fotcraft/piwithjimmy/design_enclosure/renders/back.png

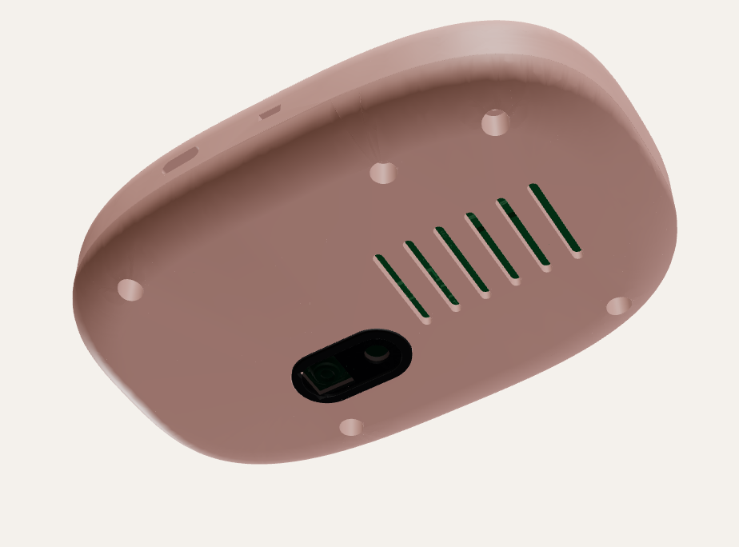
design_enclosure/renders/back.png
