fotcraft/piwithjimmy/design_enclosure/renders/buttons.png

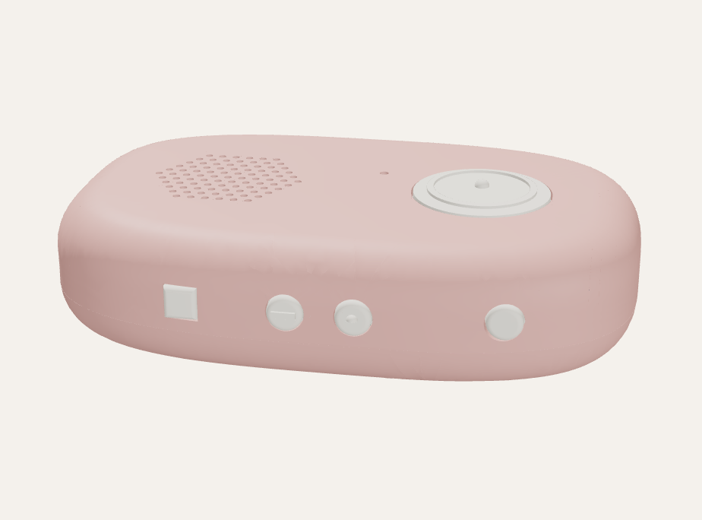
design_enclosure/renders/buttons.png
