fotcraft/piwithjimmy/design_enclosure/renders/camera.png

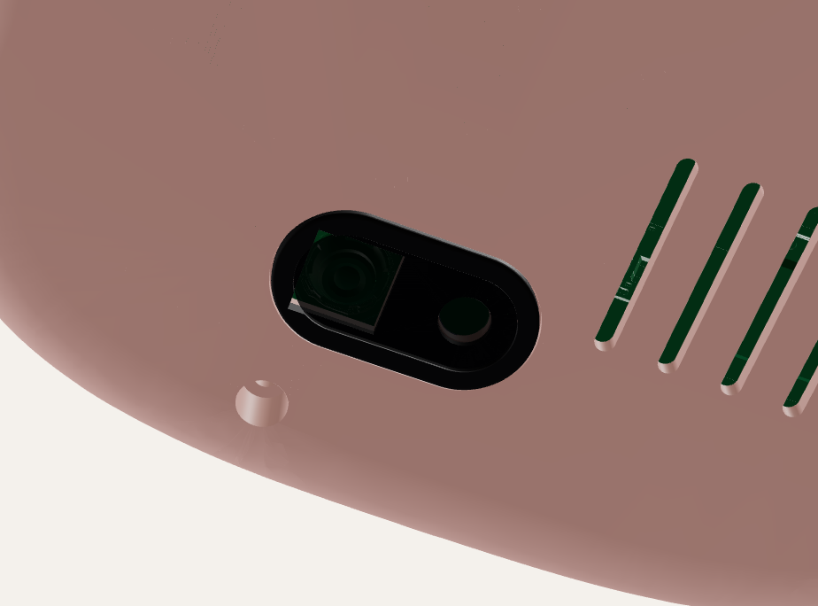
design_enclosure/renders/camera.png
