fotcraft/piwithjimmy/design_enclosure/renders/exploded.png

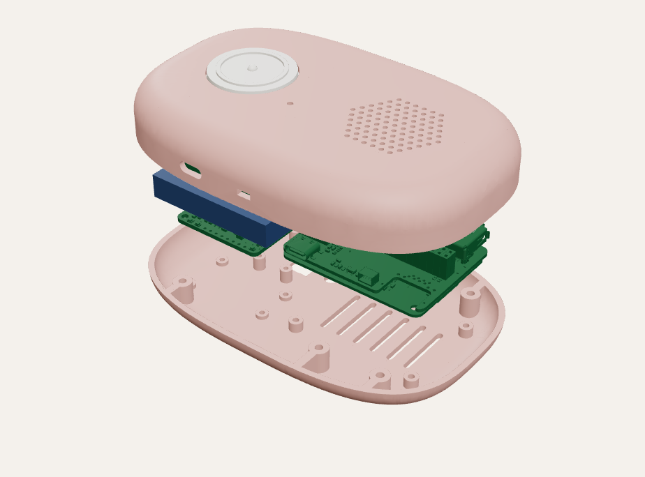
design_enclosure/renders/exploded.png
