fotcraft/piwithjimmy/design_enclosure/renders/section.png

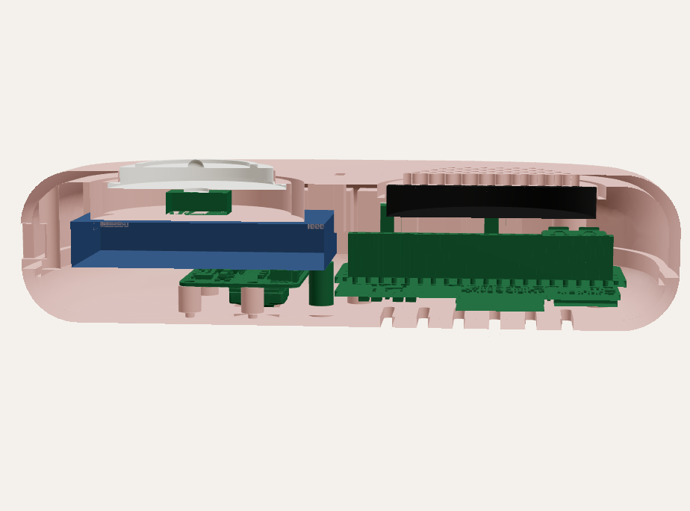
design_enclosure/renders/section.png
