fotcraft/piwithjimmy/design_enclosure/out/readable_assembly.step

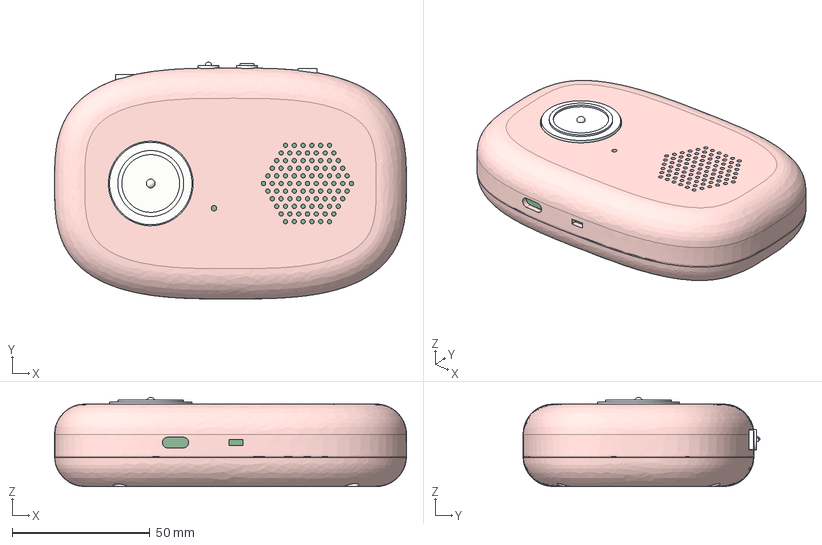
[picture p7: CAD file, 2026-11-05]
design_enclosure/out/readable_assembly.step
128.0 x 86.2 x 32.4 mm
front
back
cap_scan
cap_repeat
cap_vol_up
cap_vol_down
cap_lang
battery
speaker
amp
scan_switch
sw_repeat
sw_vol_up
sw_vol_down
sw_lang
usbc_breakout
power_switch
status_led
illum_led
