fotcraft/piwithjimmy/design_enclosure/out/cap_lang.step

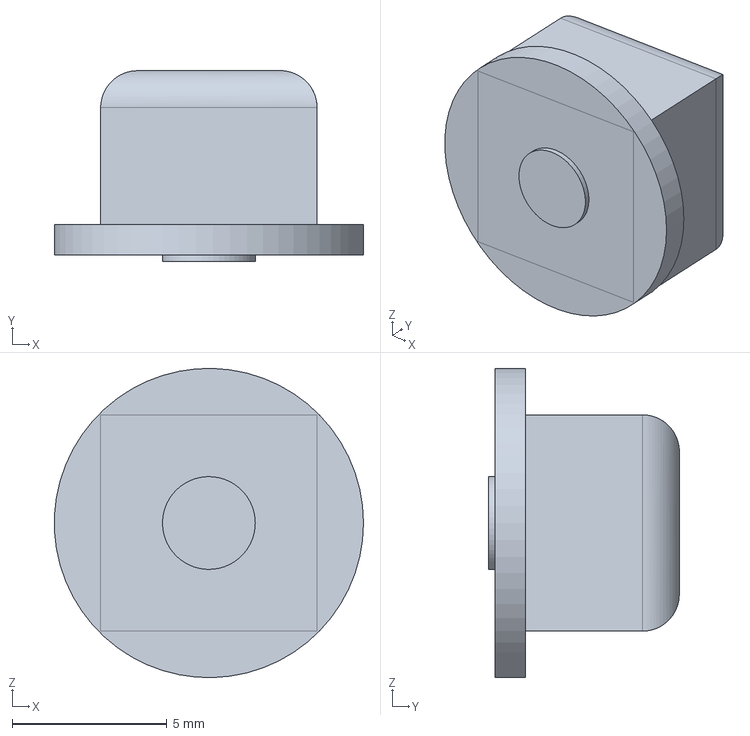
[picture p8: CAD file, 2026-11-06]
design_enclosure/out/cap_lang.step
9.99 x 6.17 x 10.00 mm
