fotcraft/piwithjimmy/design_enclosure/PowerBoost_1000C.step

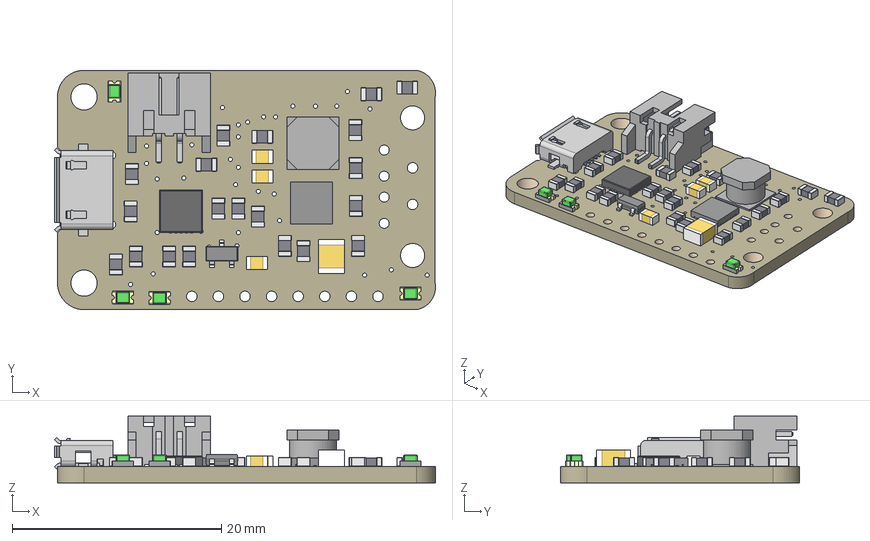
[picture p9: CAD file, 2026-02-16]
design_enclosure/PowerBoost_1000C.step
36.4 x 22.9 x 6.37 mm
Board
TPS61090RSAR
6.8uH
15K x 20
JST 2-PH
ORANGE x 4
0.1uF
1.87M x 2
MMUN2133LT1G
100uF
MicroUSB
MCP73871
