fotcraft/piwithjimmy/design_enclosure/CM5R5-3dsteps.step

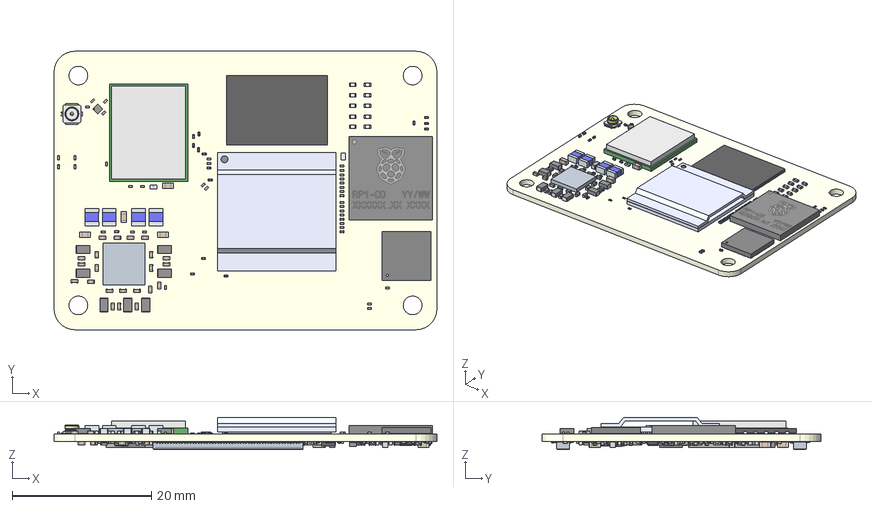
[picture p10: CAD file, 2026-02-15]
design_enclosure/CM5R5-3dsteps.step
55.0 x 40.0 x 4.62 mm
200-ball_VFBGAold.step
CAP0201.step x 190
RES0201old.step x 71
CAP0402.step x 81
PMIC STEP.STEP
3D-SRP201208-R47MH-20230512 .step x 7
term2 x 4
term1 x 4
2712 v2 STEP.STEP
CAP0603.step x 10
RES0402.step x 10
SOT883B Mold body x 4
SOT883B4 LF x 4
User Library-SKY13351-378LF.step
ProjectY v3 STEP.STEP
(Unsaved)
PinIndicator
Pads x 2
Lid x 2
Plating
LDF
CPD
Pins
User Library-153BallWFBGA
10164228-1001A1RLF.stp x 2
ABM11-0022-T3.step x 2
DIELECTRIC_Model_1_Inst
