fotcraft/piwithjimmy/design_enclosure/out/cap_scan.step

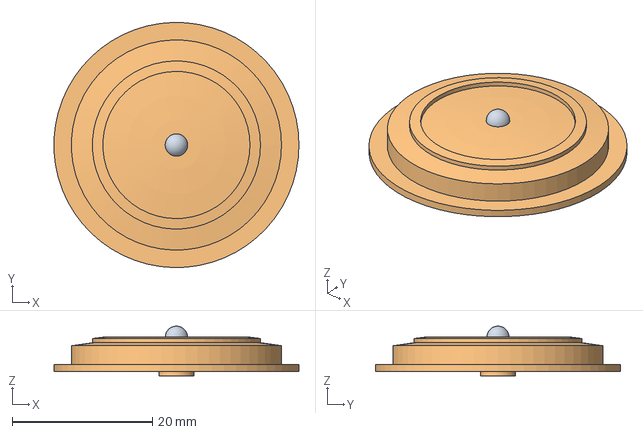
[picture p11: CAD file, 2026-11-06]
design_enclosure/out/cap_scan.step
35.0 x 35.0 x 7.10 mm
