fotcraft/piwithjimmy/design_enclosure/out/cap_vol_down.step

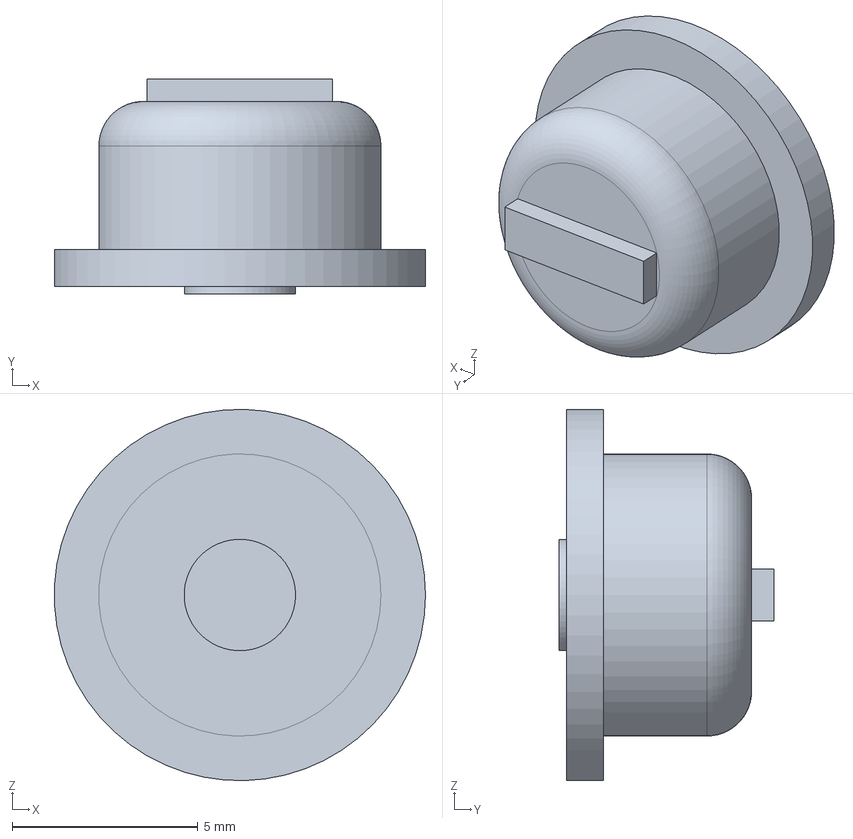
[picture p12: CAD file, 2026-11-06]
design_enclosure/out/cap_vol_down.step
9.99 x 5.79 x 10.00 mm
