fotcraft/piwithjimmy/design_enclosure/out/camera_window.step

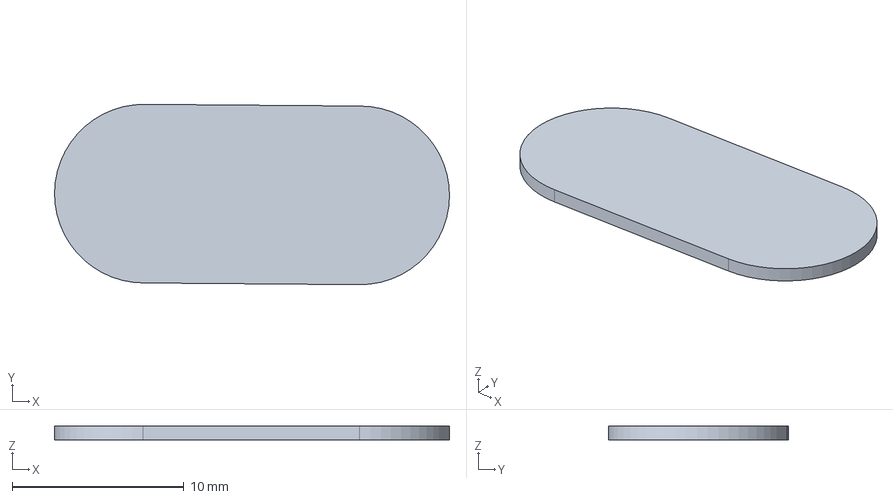
[picture p13: CAD file, 2026-11-06]
design_enclosure/out/camera_window.step
23.0 x 10.5 x 0.8 mm
