fotcraft/piwithjimmy/design_enclosure/out/cap_repeat.step

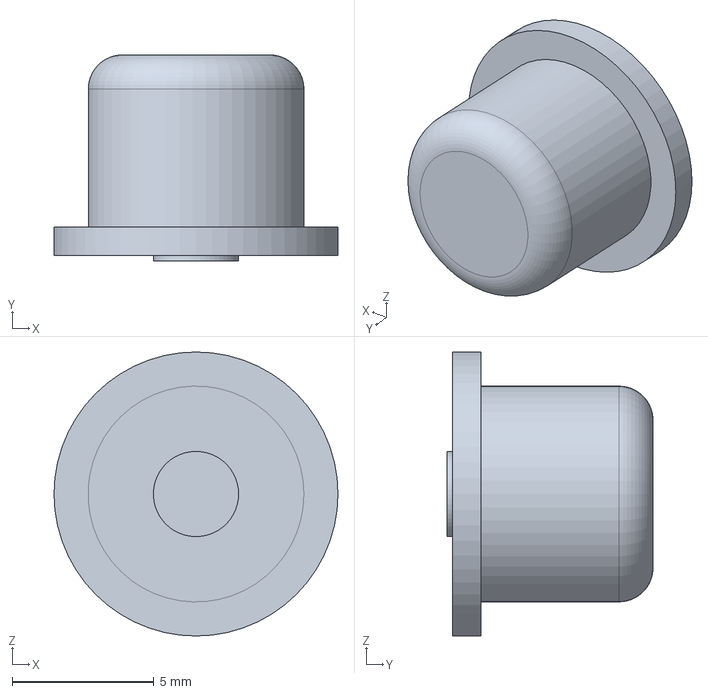
[picture p14: CAD file, 2026-11-06]
design_enclosure/out/cap_repeat.step
10.0 x 7.26 x 10.0 mm
