fotcraft/piwithjimmy/design_enclosure/out/camera_bezel.step

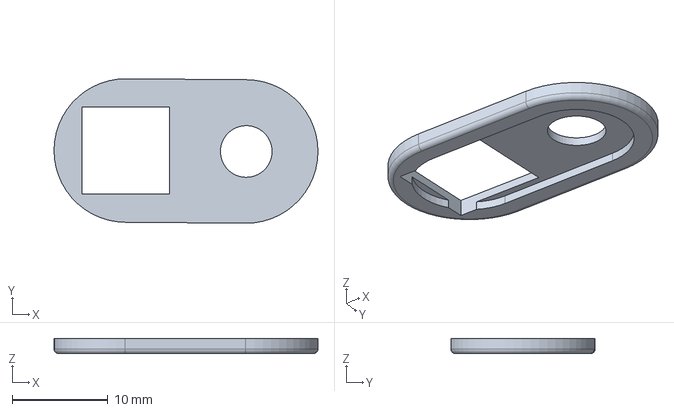
[picture p15: CAD file, 2026-11-06]
design_enclosure/out/camera_bezel.step
27.6 x 15.1 x 1.60 mm
