fotcraft/piwithjimmy/design_enclosure/out/back.step

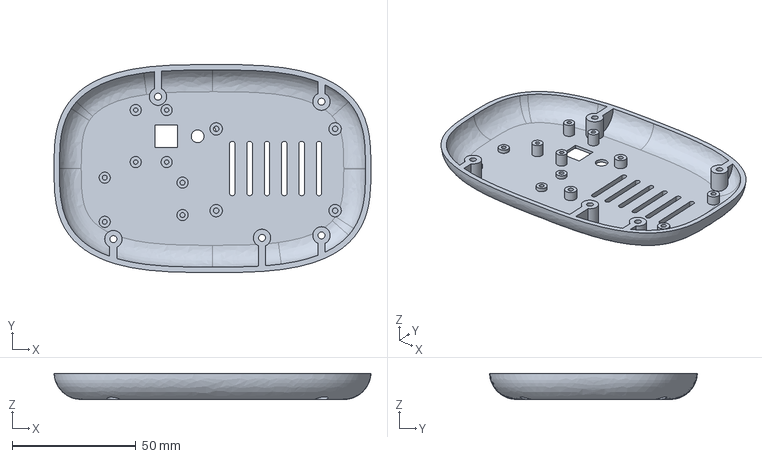
[picture p16: CAD file, 2026-11-06]
design_enclosure/out/back.step
128.0 x 84.0 x 10.5 mm
