fotcraft/piwithjimmy/design_enclosure/out/front.step

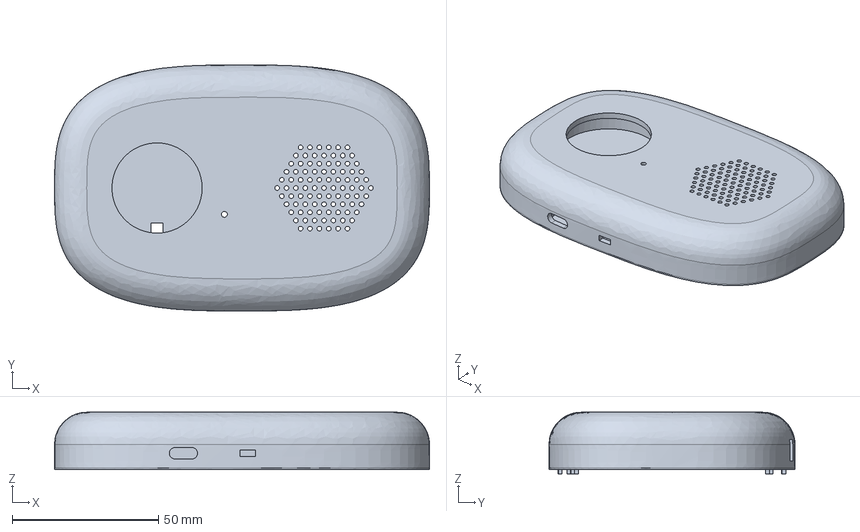
[picture p17: CAD file, 2026-11-05]
design_enclosure/out/front.step
128.0 x 84.0 x 21.0 mm
