fotcraft/piwithjimmy/design_enclosure/out/cap_vol_up.step

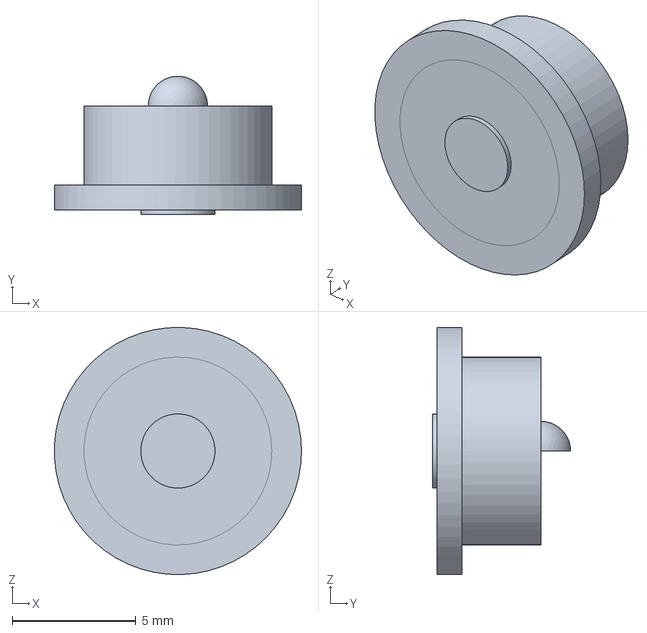
[picture p18: CAD file, 2026-11-05]
design_enclosure/out/cap_vol_up.step
9.99 x 5.60 x 10.00 mm
