fotcraft/piwithjimmy/(list of files, cad)

Other CAD files:
design_enclosure/out/back.stl
design_enclosure/out/cap_lang.stl
design_enclosure/out/cap_repeat.stl
design_enclosure/out/cap_scan.stl
design_enclosure/out/cap_vol_down.stl
design_enclosure/out/cap_vol_up.stl
design_enclosure/out/front.stl
