fotcraft/piwithjimmy/(commit log)

2026-02-15 Use Azure Read API as primary OCR for handwritten English notes
    Azure is now called first (cloud_ocr.primary: true) with local
    EasyOCR as fallback only when Azure fails. Preprocessing disabled
    to preserve handwriting, image auto-compressed to fit Azure's 4 MB
    limit, and error logging added throughout the cloud OCR path.
    [config.yaml]
2026-02-15 Add Azure Neural TTS, confidence fix, auto language detection, and enclosure STEP files
    - Azure Neural TTS (JennyNeural/AthinaNeural) with espeak-ng fallback
    - Use paplay for PipeWire/PulseAudio compatibility
    - Normalize Azure OCR confidence from 0-1 to 0-100 scale
    - Auto-detect language for OCR (supports English + Greek)
    - Add design_enclosure/ with official CM5 and Camera Module 3 STEP files
    [CM5R5-3dsteps.step]
2026-02-16 Update README with full project docs, add CM5-NANO-B and PowerBoost STEP files
    - Rewrite README with current architecture (Azure OCR + TTS),
    hardware BOM, config reference, and project structure
    - Add Waveshare CM5-NANO-B carrier board STEP file
    - Add Adafruit PowerBoost 1000C STEP file
    - Update remaining CAD download list
    [PowerBoost_1000C.step]
2026-11-05 Readable v2: Greek handwriting, offline Greek, real GPIO, audio fixes
    - Vision-language model OCR (Azure OpenAI / OpenAI / Anthropic) for
    handwriting, low confidence or empty Azure results; reads Greek handwriting,
    which Azure OCR does not support
    - Optional Azure Document Intelligence provider (lists Greek print)
    - Offline: Tesseract ell+eng by default, instant offline detection instead of
    waiting for cloud timeouts
    - gpiozero buttons (1 large + 4 small, hold Repeat for help), status and
    illumination LEDs, PowerBoost low-battery announcement
    - Audio: any button stops speech, XML-escaped SSML, disk cache for prompts,
    pactl volume with spoken level, spoken language changes, Greek pr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
2026-11-05 Parametric enclosure: two-part pebble shell around the real components
    - design_enclosure/readable_enclosure.py (CadQuery): 128 x 84 x 30 mm shell
    modelled around the CM5-NANO-B, CM5, Camera Module 3 and PowerBoost STEP
    files, with an interference check (currently clean)
    - Large Scan button with tactile ring, four side buttons with distinct
    shapes, speaker grille and ring, status and illumination LEDs, camera
    window, CM5 vents, USB-C charge port, power switch, lanyard post, five
    M2.5 screws into heat-set inserts, alignment lip
    - Print-ready STL and STEP exports in out/, renders, print and assembly guide
    Claude-Session: https: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
2026-11-06 VLM: support GPT-5-family parameters; Azure OpenAI setup guide
    - Retry with max_completion_tokens and no temperature when the model
    rejects max_tokens/temperature (GPT-5 family, o-series)
    - docs/AZURE_OPENAI_SETUP.md: resource, deployment (EU data zone), keys,
    config, tests, model choice with the benchmark, budget alert
    Claude-Session: https://claude.ai/code/session_012fxwHUnd9nHqykMNCZek5G
2026-11-06 Enclosure: camera island, soft TPU button caps, side-button clearances
    - Charcoal camera island with a flush clear acrylic window over the lens and
    the illumination LED, replacing the bare square opening
    - Button caps for TPU 85A-95A: domed Scan button (ring + dot kept), rounded
    side caps
    - Side buttons positioned from the wall's innermost point and clear of the
    front fillet; alignment lip cleared under the cap flanges (caps were
    touching the wall by ~0.2 mm)
    - Cap/shell check now exact (OCC distance + volume) instead of mesh sampling
    - README: TPU/acrylic print and assembly notes, optional 4G outdoor version
    Claude-Session: ht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
2026-11-06 IO board spec (custom PCB) and fuel-gauge battery level
    Add docs/IO_BOARD.md: a 2-layer board replacing the PowerBoost, amplifier
    breakout, USB-C breakout and hand wiring (MCP73871 + TPS61088 3 A boost,
    MAX98357A, MAX17048), with BOM, harness pin map and cost comparison.
    Software: MAX17048 support; hold Language to hear the battery level;
    low-battery warning at 10 % when the gauge is enabled.
    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
2026-11-06 Join Wi-Fi by scanning a Wi-Fi QR code
    Every scan first checks the photo for a WIFI: QR code (router sticker or a
    phone's Share Wi-Fi screen). The device reads the network name aloud, waits for
    a second Scan press to confirm, joins with nmcli and announces the result in
    Greek or English. The password is never spoken or logged.
    Adds app/wifi_qr.py, prompts, config, a polkit rule for the user service,
    docs/WIFI_SETUP.md, tools/wifi_qr_check.py and tests.
    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
